vmercy/TO52_helice_holographique/hardware/liste_materiel.pdf

Sheet1

Désignation | Caractéristiques | Exemple réf | Quantité
Raspberry Pi Zero (+ accessoires) | | | 1
Raspberry Pi 4 (+ accessoires) | | | 1
Bague collectrice creuse | 2A 6 fils | | 1
Bandeau 144 LED RGB | LED Adressables | APA102C | 1
Moteur brushless + ESC | ~ 1000KV | A2212/13T | 1
Motoréducteur CC 12v | V>400 RPM, C>4500 gcmJGA25-370 | | 1
Pont en H | Imax >= 2A | L298N | 1
Capteur à effet hall | | KY-035 | 1
Aimant | pour utiliser avec le capteur à effet Hall | | 1
Module gyroscope | avec magnétomètre | LSM9DS1 | 1
Alimentation ATX | V=12V + 5V, P=500W | TECNOWARE F | 1
Plexiglas transparent (à découper au las2/3/4/5mm d’épaisseur
Visserie

Prix unitaire | Prix total | Etat | URL
| 0.00 € Déjà fourni par M. Gechter
| 0.00 € Déjà fourni par M. Gechter
18.56 € | 18.56 € À commander
| 0.00 € Déjà au Crunch Lab
21.99 € | 21.99 € À commander
13.99 € | 13.99 € À commander
13.99 € | 13.99 € À commander
8.49 € | 8.49 € À commander
9.99 € | 9.99 € À commander
25.00 € | 25.00 € À commander
15.99 € | 15.99 € À commander
| | Déjà au Crunch Lab
| | Déjà au Crunch Lab

Total
128.00 €

https://www.amazon.fr/collectrice-Puissance-%C3%A9lectrique-conducteur-Connecteur/dp/B085MGKJ1C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

https://www.amazon.fr/Kyrio-Brushless-Accessoires-Montage-Quadcopter/dp/B08N9W4V3Y/ref=sr_1_1_sspa
https://www.amazon.fr/Haoweiwei-HWW-DDJQD-JGA25-370-Motor%C3%A9ducteur-%C3%A9lectrique/dp/B092QKWJ4C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 https://www.amazon.fr/AZDelivery-Capteur-magn%C3%A9tique-analogique-Arduino/dp/B07ZZ8N4VC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
https://www.amazon.fr/n%C3%A9odyme-diam%C3%A8tre-d%C3%A9paisseur-Traction-Magenesis%C2%AE/dp/B06X977K8L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
https://www.amazon.fr/Adafruit-9-DOF-Accel-Breakout-Board/dp/B06XJ4XZHL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
https://www.amazon.fr/Tecnoware-dalimentation-Office-Silent-Ventilateur/dp/B084W8Y687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

Commentaire

déjà récupéré

sûrement déjà au Crunch Lab
1 seul capteur est nécessaire
n’importe quel aimant de petite taille peut convenir

peut aussi être récupérée sur un PC UTBM hors d’usage https://www.amazon.fr/collectrice-Puissance-%C3%A9lectrique-conducteur-Connecteur/dp/B085MGKJ1C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 M%C3%85%C5%BD%C3%95%C3%91&dchild=1&keywords=bague+collectrice&qid=1634898240&sr=8-23

https://www.amazon.fr/Kyrio-Brushless-Accessoires-Montage-Quadcopter/dp/B08N9W4V3Y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 https://www.amazon.fr/Haoweiwei-HWW-DDJQD-JGA25-370-Motor%C3%A9ducteur-%C3%A9lectrique/dp/B092QKWJ4C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 =%C3%85M%C3%85%C5%BD%C3%95%C3%91&dchild=1&keywords=motor%C3%A9ducteur%2B12v%2B1000%2Brpm&qid=1634899626&sr=8-3&th=1

https://www.amazon.fr/Adafruit-9-DOF-Accel-Breakout-Board/dp/B06XJ4XZHL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 D%C3%95%C3%91&dchild=1&keywords=lsm9ds1&qid=1634899106&sr=8-1

M%C3%85%C5%BD%C3%95%C3%91&dchild=1&keywords=bague+collectrice&qid=1634898240&sr=8-23

?dchild=1&keywords=moteur+brushless+1000kv&qid=1634897868&sr=8-1-spons&psc=1&spLa=ZW5jcnlwdGVkUXVhbGlmaWVyPUExQjg5MTBKTDBBRUFUJmVuY3J5cHRlZElkPUEwOTA5NjE1M0cwQ0tTSVY0VEMyNyZlbmNyeXB0ZWRBZElkPUEwMDQ1Njc3MlYyMEtYUFNQUDlIMyZ3aWRnZXROYW1lPXNwX2F0ZiZhY3Rpb249Y2xpY2tSZWRpcmVjdCZkb05vdExvZ0NsaWNrPXRydWU= =%C3%85M%C3%85%C5%BD%C3%95%C3%91&dchild=1&keywords=motor%C3%A9ducteur%2B12v%2B1000%2Brpm&qid=1634899626&sr=8-3&th=1

D%C3%95%C3%91&dchild=1&keywords=lsm9ds1&qid=1634899106&sr=8-1

déjà au crunchlab
commandé
déjà fourni
