vmercy/TO52_helice_holographique/hardware/APA102C_pinout.png

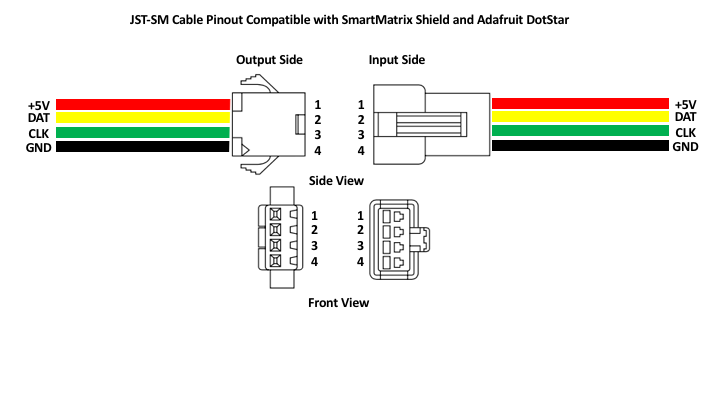
hardware/APA102C_pinout.png
