vmercy/TO52_helice_holographique/hardware/liste_materiel.ods

Sheet: Sheet1
Désignation | Caractéristiques | Exemple réf | Quantité | Prix unitaire | Prix total | Etat | URL | Commentaire
Raspberry Pi Zero (+ accessoires) |  |  | 1 |  | 0.00 € | Déjà fourni par M. Gechter
Raspberry Pi 4 (+ accessoires) |  |  | 1 |  | 0.00 € | Déjà fourni par M. Gechter
Bague collectrice creuse | 2A 6 fils |  | 1 | 18.56 € | 18.56 € | À commander | https://www.amazon.fr/collectrice-Puissance-%C3%A9lectrique-conducteur-Connecteur/dp/B085MGKJ1C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 M%C3%85%C5%BD%C3%95%C3%91&dchild=1&keywords=bague+collectrice&qid=1634898240&sr=8-23
Bandeau 144 LED RGB | LED Adressables | APA102C | 1 |  | 0.00 € | Déjà au Crunch Lab |  | déjà récupéré
Moteur brushless + ESC | ~ 1000KV | A2212/13T | 1 | 21.99 € | 21.99 € | À commander | https://www.amazon.fr/Kyrio-Brushless-Accessoires-Montage-Quadcopter/dp/B08N9W4V3Y
Motoréducteur CC 12v | V>400 RPM, C>4500 gcm | 25GA-370 | 1 | 20.09 € | 20.09 € | À commander | https://www.amazon.fr/FTVOGUE-engrenages-bricolage-%C3%A9lectronique-5-1000RPM/dp/B07W51WLTW ?dchild=1&keywords=moteur+12v+1000rpm&qid=1634903813&sr=8-6
Pont en H | Imax >= 2A | L298N | 1 | 13.99 € | 13.99 € | À commander | https://www.amazon.fr/modules-contr%C3%B4leur-moteur-Arduino-L298N/dp/B094FHW2TY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 (https://www.amazon.fr/modules-contrôleur-moteur-Arduino-L298N/dp/B094FHW2TY?__mk_fr_FR=ÅMÅŽÕÑ) | sûrement déjà au Crunch Lab (un seul module est nécessaire)
Capteur à effet hall |  | KY-035 | 1 | 8.49 € | 8.49 € | À commander | https://www.amazon.fr/AZDelivery-Capteur-magn%C3%A9tique-analogique-Arduino/dp/B07ZZ8N4VC?__mk_fr_FR=%C3%85 M%C3%85%C5%BD%C3%95%C3%91&dchild=1&keywords=capteur+%C3%A0+effet+hall&qid=1634550226&sr=8-2-spons&psc=1&smid=A1X7QLRQH87QA3&spLa=ZW5jcnlwdGVkUXVhbGlmaWVyPUEzQVlCMEpYNjJaRldEJmVuY3J5cHRlZElkPUEwMTQxODI5MkUyWUkzVTJETjNRViZlbmNyeXB0ZWRBZElkPUEwODgwMjcxMjBVVjY0VE1aSjVYTyZ3aWRnZXROYW1lPXNwX2F0ZiZhY3Rpb249Y2xpY2tSZWRpcmVjdCZkb05vdExvZ0NsaWNrPXRydWU= | 1 seul capteur est nécessaire
Aimant | pour utiliser avec le capteur à effet Hall |  | 1 | 9.99 € | 9.99 € | À commander | https://www.amazon.fr/n%C3%A9odyme-diam%C3%A8tre-d%C3%A9paisseur-Traction-Magenesis%C2%AE/dp/B06X977K8L ?__mk_fr_FR=%C3%85M%C3%85%C5%BD%C3%95%C3%91&dchild=1&keywords=aimant&qid=1634899012&sr=8-1-spons&psc=1&spLa=ZW5jcnlwdGVkUXVhbGlmaWVyPUExUlBNQ0tCV00yQTZTJmVuY3J5cHRlZElkPUEwMjkyNjA4TUwyOTk4TlFNTzNMJmVuY3J5cHRlZEFkSWQ9QTAyOTYwOThPNkJHQ0s4SVBDMTkmd2lkZ2V0TmFtZT1zcF9hdGYmYWN0aW9uPWNsaWNrUmVkaXJlY3QmZG9Ob3RMb2dDbGljaz10cnVl (https://www.amazon.fr/néodyme-diamètre-dépaisseur-Traction-Magenesis®/dp/B06X977K8L/ref=sr_1_1_sspa) | n’importe quel aimant de petite taille peut convenir
Module gyroscope | avec magnétomètre | LSM9DS1 | 1 | 25.00 € | 25.00 € | À commander | https://www.amazon.fr/Adafruit-9-DOF-Accel-Breakout-Board/dp/B06XJ4XZHL?__mk_fr_FR=%C3%85M%C3%85%C5%B D%C3%95%C3%91&dchild=1&keywords=lsm9ds1&qid=1634899106&sr=8-1
Alimentation ATX | V=12V + 5V, P=500W | TECNOWARE FREE SILENT 500W | 1 | 15.99 € | 15.99 € | À commander | https://www.amazon.fr/Tecnoware-dalimentation-Office-Silent-Ventilateur/dp/B084W8Y687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 D%C3%95%C3%91&dchild=1&keywords=alimentation%2Bpc&qid=1634900601&sr=8-14&th=1 | peut aussi être récupérée sur un PC UTBM hors d’usage
Plexiglas transparent (à découper au laser) | 2/3/4/5mm d’épaisseur |  |  |  |  | Déjà au Crunch Lab
Visserie |  |  |  |  |  | Déjà au Crunch Lab
 |  |  |  |  | Total
 |  |  |  |  | 134.10 €

Sheet: Sheet2
déjà au crunchlab
commandé
déjà fourni
