vmercy/TO52_helice_holographique/POVSimulator/result_maskApplicationMethod.png

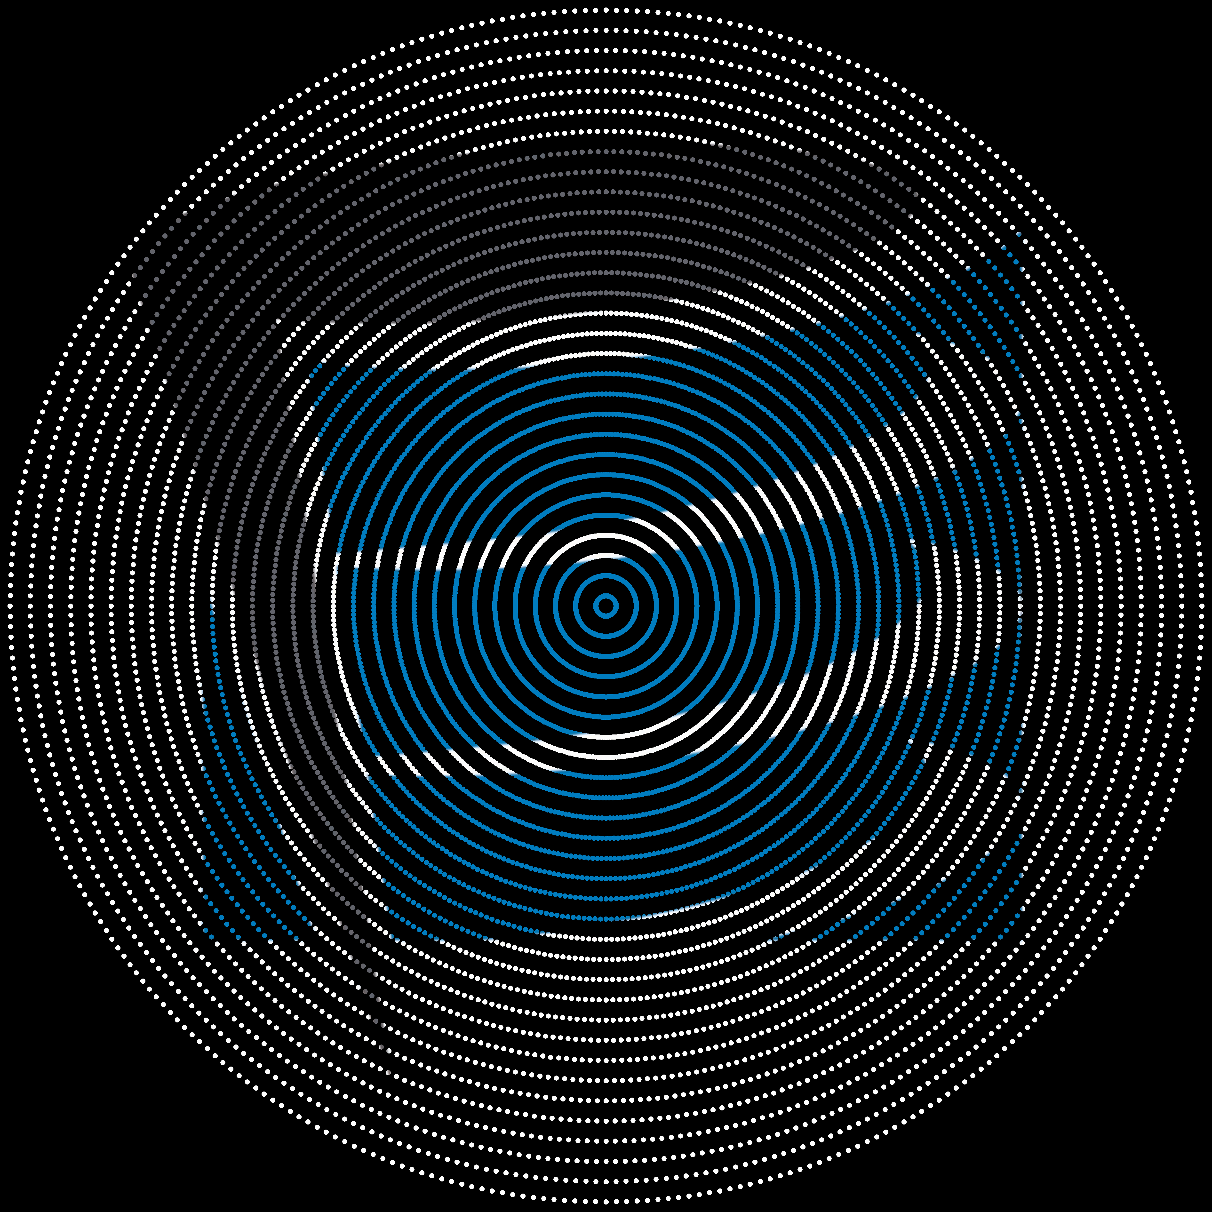
POVSimulator/result_maskApplicationMethod.png
