vmercy/TO52_helice_holographique/POVSimulator/result_picking.png

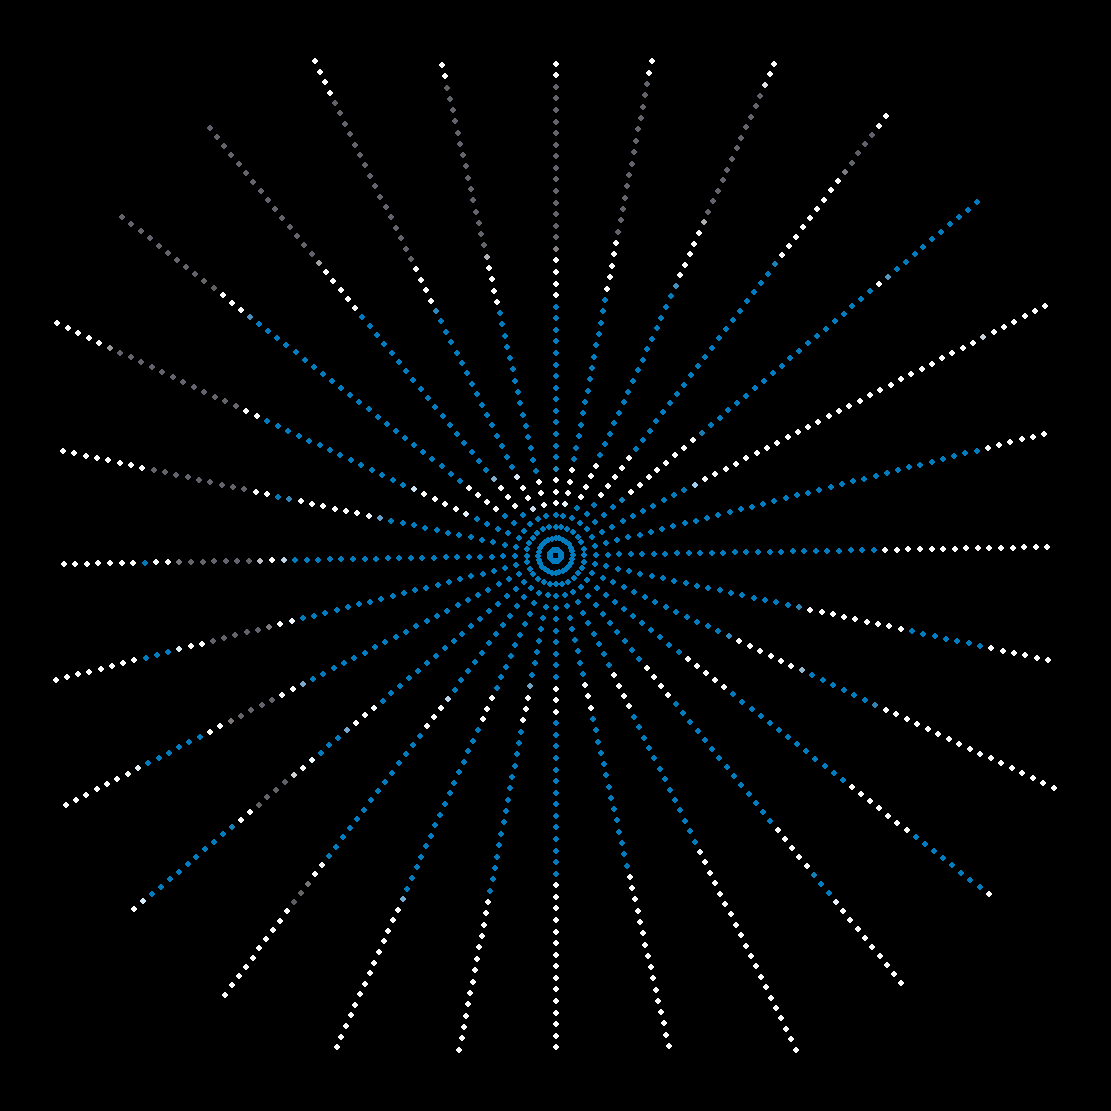
POVSimulator/result_picking.png
