vmercy/TO52_helice_holographique/main/main.py

#!/usr/bin/python3

"""Main script including control interface as web server
"""
from logging import warning
from dotenv import load_dotenv
import os
from flask import Flask, render_template, url_for, request, flash, redirect, send_from_directory
from werkzeug.utils import secure_filename
from time import sleep, time
import RPi.GPIO as GPIO
from buzzer import Buzzer
from converter.converter import *
import subprocess
import signal
import sys
import os

ABSOLUTE_PATH = os.path.dirname(os.path.abspath(__file__))+'/'

load_dotenv()

displayerSubprocess = None

def sigint_handler(sig, frame):
  global displayerSubprocess
  """Handler for SIGINT signal

  Args:
      sig (signal): signal received
      frame (frame): unused
  """
  buzz.error()
  stopDisplayer(True, displayerSubprocess)
  sys.exit(0)

signal.signal(signal.SIGINT, sigint_handler) #associate SIGINT with its handler

UPLOAD_FOLDER = 'img_uploaded'
ALLOWED_EXTENSIONS = {'png', 'jpg', 'jpeg'}
RADIAL_RESOLUTION_BOUNDS = {'min':1,'max':48}
ANGULAR_RESOLUTION_BOUNDS = {'min':1,'max':50}

RUN_ALLOWED = False

BUZZER_PIN = 22 #BCM
MOTOR_PIN = 6 #BCM

GPIO.setmode(GPIO.BCM)
GPIO.setup(MOTOR_PIN, GPIO.OUT)

buzz = Buzzer(BUZZER_PIN, GPIO)
buzz.setEnable(True)

def startSequence():
  """Play a visual and sonor alert to make sure that display is alive
  """
  stopDisplayer()
  flashStrip('green', 1)
  buzz.start()

def compileFlashStripIfNotAlreadyDone():
  """Checks if displayer/bin/flash_strip has been compiled and compile it if not
  """
  if not os.path.exists(ABSOLUTE_PATH+'displayer/bin/flash_strip'):
    subprocess.Popen(["make","flash_strip"], stdout=subprocess.PIPE, cwd=ABSOLUTE_PATH+"displayer").wait()

def compileDisplayer():
  """Compiles C program responsible for displaying image on propeller after updating .h file
  """
  subprocess.Popen(["make","cleanDisplayer"], stdout=subprocess.PIPE, cwd=ABSOLUTE_PATH+"displayer").wait()
  subprocess.Popen(["make","displayer"], stdout=subprocess.PIPE, cwd=ABSOLUTE_PATH+"displayer").wait()

def warnBeforeStart():
  """Play a visual and sonor alert before starting the propeller for safety reasons
  """
  for i in range(3):
    flashStrip("yellow", 1)
    buzz.warn()
    sleep(0.5)

def flashStrip(color, delay):
  """Flashes LED strip 

  Args:
      color (string): The expected color for flashing. Can be red, yellow or green
      delay (int): The time of flashing in milliseconds
  """
  allowedColors = ['red', 'yellow', 'green']
  if color not in allowedColors:
    return
  subprocess.Popen(["./flash_strip",str(allowedColors.index(color)),str(delay)], stdout=subprocess.PIPE, cwd=ABSOLUTE_PATH+"displayer/bin")

def startDisplayer(angularResolution, radialResolution):
  """Starts displayer subprocess

  Args:
      angularResolution (int): Angular resolution (number of displaying sectors)
      radialResolution (int): Radial resolution (number of LEDs)

  Returns:
      subprocess: subprocess created for displayer
  """
  warnBeforeStart()
  GPIO.output(MOTOR_PIN, GPIO.HIGH)
  return subprocess.Popen(["./displayer",str(angularResolution),str(radialResolution)], stdout=subprocess.PIPE, cwd=ABSOLUTE_PATH+"displayer/bin")

def stopDisplayer(skipBuzz = False, subProcessToKill = None):
  """Stops display motor

  Args:
      skipBuzz (bool): If true, buzzer won't play any sound
  """
  GPIO.output(MOTOR_PIN, GPIO.LOW)
  flashStrip(0, 1)
  if not skipBuzz:
    buzz.shutDown()
  if subProcessToKill:
    subProcessToKill.terminate()

def isFilenameAllowed(filename):
  """Evaluates whether the filename can be accepted or not

  Args:
      filename (string): user input filename

  Returns:
      bool: True if filename is accepter, False otherwise
  """
  global ALLOWED_EXTENSIONS
  return '.' in filename and \
           filename.rsplit('.', 1)[1].lower() in ALLOWED_EXTENSIONS

startSequence()
app = Flask(__name__)
app.config['UPLOAD_FOLDER'] = UPLOAD_FOLDER
app.secret_key = os.environ.get("flask_secret")

compileFlashStripIfNotAlreadyDone()

@app.route('/uploads/<path:filename>')
def download_file(filename):
    return send_from_directory('preview', filename, as_attachment=True)

angular_res_input = None
radial_res_input = None

@app.route("/", methods=['GET', 'POST'])
def home():
  global RUN_ALLOWED, angular_res_input, radial_res_input
  if request.method == 'POST':
    if RUN_ALLOWED:
      if request.form.get('command') == 'run_prop':
        startDisplayer(angular_res_input, radial_res_input)
        flash('Hélice démarrée avec succès','success')
        return render_template('index.html',preview_url="preview/preview.png", RUN_ALLOWED = RUN_ALLOWED, startBtnDisabled = True, stopBtnDisabled = False)
      elif request.form.get('command') == 'stop_prop':
        stopDisplayer(subProcessToKill=displayerSubprocess)
        flash('Hélice arrêtée avec succès','info')
        return render_template('index.html',preview_url="preview/preview.png", RUN_ALLOWED = RUN_ALLOWED, startBtnDisabled = False, stopBtnDisabled = True)
    RUN_ALLOWED = False
    angular_res_input = int(request.form.get('angular_resolution'))
    radial_res_input = int(request.form.get('radial_resolution'))
    if not isinstance(angular_res_input, int) :
      flash('La résolution angulaire saisie en 3 doit être un entier',"warning")
      return redirect(request.url)
    if angular_res_input > ANGULAR_RESOLUTION_BOUNDS['max'] or angular_res_input < ANGULAR_RESOLUTION_BOUNDS['min']:
      flash('La résolution angulaire doit être comprise entre %i et %i'%(ANGULAR_RESOLUTION_BOUNDS['min'], ANGULAR_RESOLUTION_BOUNDS['max']),"warning")
      return redirect(request.url)
    if not isinstance(angular_res_input, int) :
      flash('La résolution radiale saisie en 2 doit être un entier',"warning")
      return redirect(request.url)
    if radial_res_input > RADIAL_RESOLUTION_BOUNDS['max'] or radial_res_input < RADIAL_RESOLUTION_BOUNDS['min']:
      flash('La résolution radiale doit être comprise entre %i et %i'%(RADIAL_RESOLUTION_BOUNDS['min'], RADIAL_RESOLUTION_BOUNDS['max']),"warning")
      return redirect(request.url)
    #check image input file
    if 'image_to_display' not in request.files:
        flash('Aucun fichier envoyé',"warning")
        return redirect(request.url)
    file = request.files['image_to_display']
    if file.filename == '':
        flash('Aucun fichier sélectionné', warning)
        return redirect(request.url)
    if not isFilenameAllowed(file.filename):
        flash('Fichier image invalide, seuls les fichiers au format .png, .jpg ou .jpeg sont acceptés', 'warning')
        return redirect(request.url)
    if file and isFilenameAllowed(file.filename):
            filename = secure_filename(file.filename)
            fullpath = os.path.join(app.config['UPLOAD_FOLDER'], filename)
            file.save(fullpath)

            # Configuration variables
            nbEllipsesPerDiametralLine = 2*radial_res_input
            imageFileName = fullpath
            outputFileName = 'static/preview.png'
            nbSectors = angular_res_input #number of displaying sectors
            angleStep = int(180/nbSectors)
            zoomFactor = 90 #zoom factor in percent

            sourceImg = Image.open(imageFileName)
            sourceImg.convert('RGBA')
            imgMaxSize = max(sourceImg.size)
            baseImgSize = imgMaxSize*100//zoomFactor
            centeredImage = Image.new('RGB', (baseImgSize,)*2,'black')
            
            centeredImage.paste(sourceImg,((baseImgSize-sourceImg.size[0])//2,(baseImgSize-sourceImg.size[1])//2))

            pickingPoints = getPickingPoints(baseImgSize, nbEllipsesPerDiametralLine, angleStep)
            pickedColors = pickColors(pickingPoints, centeredImage)

            savePickedColors('./displayer/sequenced_image.h', pickedColors, nbSectors)
            renderPickedPointsPreview(outputFileName, pickedColors, 10)

            flash('Image importée et traitée avec succès, prévisualisation en cours', 'warning')

            compileDisplayer()

            RUN_ALLOWED = True
            
            return render_template('index.html',preview_url="preview/preview.png", RUN_ALLOWED = RUN_ALLOWED)
  return render_template('index.html')

if __name__=="__main__":
  app.debug = True
  app.run(host='0.0.0.0')
