vmercy/TO52_helice_holographique/main/displayer/sequenced_image.h

#define COLOR_POINTS \
{\
{ 0, -34, 0, 0, 0 },\
{ 0, -33, 0, 0, 0 },\
{ 0, -32, 0, 0, 0 },\
{ 0, -31, 253, 253, 253 },\
{ 0, -30, 253, 253, 253 },\
{ 0, -29, 99, 99, 108 },\
{ 0, -28, 98, 99, 107 },\
{ 0, -27, 98, 99, 107 },\
{ 0, -26, 98, 99, 107 },\
{ 0, -25, 98, 99, 107 },\
{ 0, -24, 98, 99, 107 },\
{ 0, -23, 98, 99, 107 },\
{ 0, -22, 98, 99, 107 },\
{ 0, -21, 98, 99, 107 },\
{ 0, -20, 98, 99, 107 },\
{ 0, -19, 105, 101, 103 },\
{ 0, -18, 253, 253, 253 },\
{ 0, -17, 253, 253, 253 },\
{ 0, -16, 250, 252, 253 },\
{ 0, -15, 0, 124, 191 },\
{ 0, -14, 0, 124, 191 },\
{ 0, -13, 0, 124, 191 },\
{ 0, -12, 0, 124, 191 },\
{ 0, -11, 0, 124, 191 },\
{ 0, -10, 0, 124, 191 },\
{ 0, -9, 0, 124, 191 },\
{ 0, -8, 0, 124, 191 },\
{ 0, -7, 0, 124, 191 },\
{ 0, -6, 0, 124, 191 },\
{ 0, -5, 98, 166, 201 },\
{ 0, -4, 249, 251, 253 },\
{ 0, -3, 250, 252, 253 },\
{ 0, -2, 0, 124, 191 },\
{ 0, -1, 0, 124, 191 },\
{ 0, 0, 0, 124, 191 },\
{ 0, 0, 0, 124, 191 },\
{ 0, 1, 0, 124, 191 },\
{ 0, 2, 0, 124, 191 },\
{ 0, 3, 0, 124, 191 },\
{ 0, 4, 0, 124, 191 },\
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
}
