vmercy/TO52_helice_holographique/main/displayer/logo_utbm.h

#define COLOR_POINTS \
{\
{ 0, -34, 0, 0, 0 },\
{ 0, -33, 0, 0, 0 },\
{ 0, -32, 0, 0, 0 },\
{ 0, -31, 0, 0, 0 },\
{ 0, -30, 0, 0, 0 },\
{ 0, -29, 0, 0, 0 },\
{ 0, -28, 0, 0, 0 },\
{ 0, -27, 0, 0, 0 },\
{ 0, -26, 0, 0, 0 },\
{ 0, -25, 0, 0, 0 },\
{ 0, -24, 0, 0, 0 },\
{ 0, -23, 0, 0, 0 },\
{ 0, -22, 0, 0, 0 },\
{ 0, -21, 0, 0, 0 },\
{ 0, -20, 0, 0, 0 },\
{ 0, -19, 0, 0, 0 },\
{ 0, -18, 0, 0, 0 },\
{ 0, -17, 0, 0, 0 },\
{ 0, -16, 0, 0, 0 },\
{ 0, -15, 0, 0, 0 },\
{ 0, -14, 0, 0, 0 },\
{ 0, -13, 0, 0, 0 },\
{ 0, -12, 0, 0, 0 },\
{ 0, -11, 255, 255, 255 },\
{ 0, -10, 255, 255, 255 },\
{ 0, -9, 255, 255, 255 },\
{ 0, -8, 255, 255, 255 },\
{ 0, -7, 19, 117, 188 },\
{ 0, -6, 19, 117, 188 },\
{ 0, -5, 19, 117, 188 },\
{ 0, -4, 19, 117, 188 },\
{ 0, -3, 19, 117, 188 },\
{ 0, -2, 19, 117, 188 },\
{ 0, -1, 0, 112, 186 },\
{ 0, 0, 19, 117, 188 },\
{ 0, 0, 19, 117, 188 },\
{ 0, 1, 255, 255, 255 },\
{ 0, 2, 255, 255, 255 },\
{ 0, 3, 255, 255, 255 },\
{ 0, 4, 35, 31, 32 },\
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
}
