vmercy/TO52_helice_holographique/(commit log)

2021-09-27 created drillHoles function
2021-10-05 added LED strip script file
2021-10-06 wrote led strip test script
2021-10-06 blink all leds
2021-10-06 added delay print
2021-10-06 print duree
2021-10-06 solved division by 0
    [main.py]
2021-10-06 clenup a la fin
2021-10-06 start at 500 hz
2021-10-06 back to 500 hz
2021-10-06 700 hz
2021-10-06 fixed wrong argument index
    [main.py]
2021-10-11 changed pin
2021-10-22 added material list
    [liste_materiel.ods]
2021-11-17 try different spi interface
2021-12-10 test changing SPI channem
2021-12-11 customized wiringPiSPI
2021-12-11 testing wiringPiSPI lib modification to allow use of SPI1
2021-12-11 fixed missing parameter in function prototype
2021-12-11 fixed prototype
2021-12-13 replaced by utbm logo
    [logo_utbm.h]
2022-01-13 flash led on SIGINT
